ElectronicsClubAltona/Swag-Badge/Rockling-LayoutTest/Images/Rockling 02.jpg

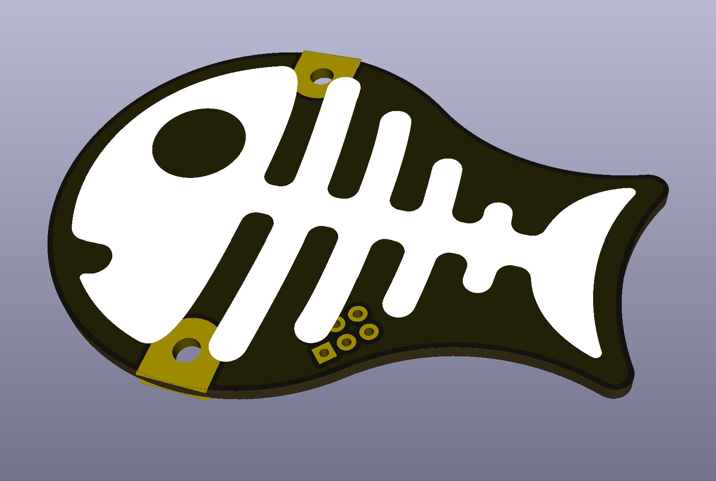
Rockling-LayoutTest/Images/Rockling 02.jpg
