ElectronicsClubAltona/Swag-Badge/Tiling The Plane.jpg

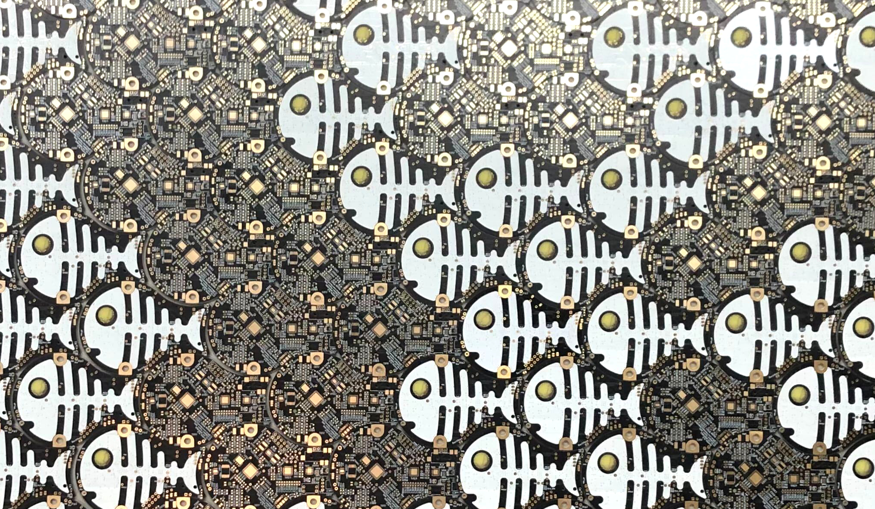
Tiling The Plane.jpg
