ElectronicsClubAltona/Swag-Badge/Swag-Badge-2022/README.md

# Linux Conf AU 2021 Swag Badge

Hardware design files for the [LCA 2022](http://lca2022.linux.org.au/) attendee swag badge.

See the [Swag Badge](http://www.openhardwareconf.org/wiki/Swagbadge2021) wiki for project details.

A project by Melbourne [Connected Community HackerSpace](https://www.hackmelbourne.org/)

Licensed under MIT (See the [license](LICENSE) file)
