ElectronicsClubAltona/Swag-Badge/Swag-Badge-2022/Resource/320 x 240 SPI Screen Spec.rtf

MRD_TFT240_8P_CS
Banggood
https://www.banggood.com/2_4-Inch-240320-Color-HD-LCD-TFT-Screen-SPI-Serial-Display-Module-ILI9341-p-1384915.html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
AliExpress
https://www.aliexpress.com/item/1005001543742305.html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 (https://www.aliexpress.com/item/1005001543742305.html)

Feature:

Size: 2.4 inches
Drive chip: ILI9341
Touch type: without touching
Resolution: 240*320
Communication interface: SPI

Interface description:

1. GND (power ground)
2. VCC (power supply is 3.3V)
3. CLK (clock line)
4. MOSI (data input)
5. RES (reset line)
6. DC (data / command selection line)
7. BLK (backlight)
8. MISO (data output)

Pin description:

If you want to save IO port, BLK backlight can not be connected. The system has been designed to illuminate the backlight even if it is not connected. If you need to turn off the backlight, you need to connect BLK to low level or directly to ground.
MISO is the output signal of the screen. If you do not need to read the information of the screen, this pin can be disconnected. A minimum of 4 IO ports are required to operate.
