ElectronicsClubAltona/Swag-Badge/Tiling The Plane 02.jpg

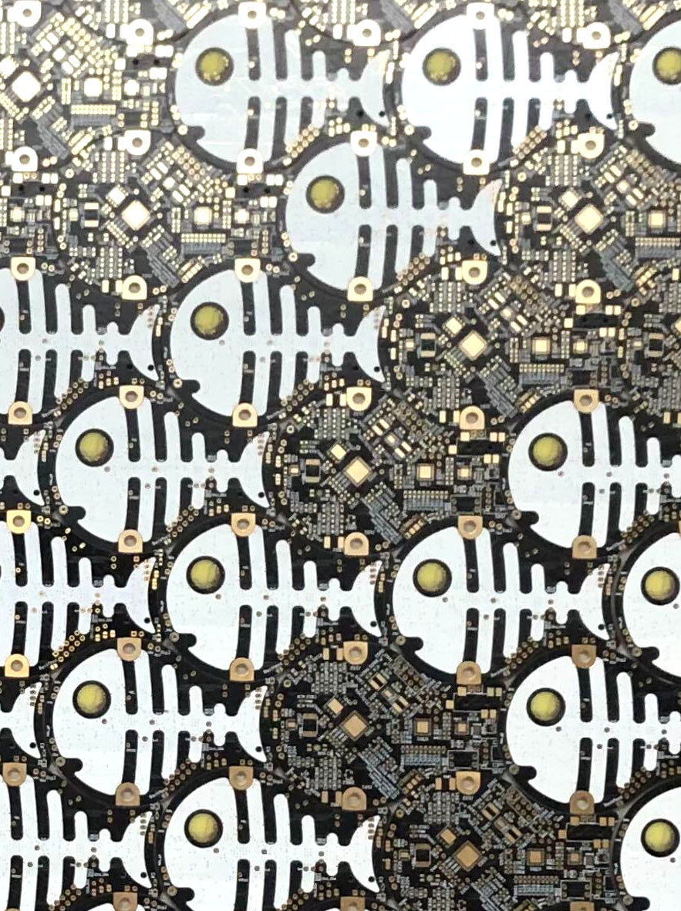
Tiling The Plane 02.jpg
