ElectronicsClubAltona/Swag-Badge/Tux Eyes/Tux Eyes - No Pupils 01.png

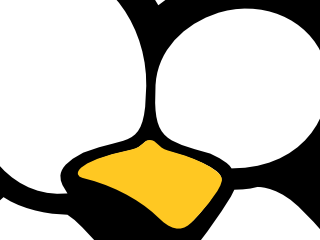
Tux Eyes/Tux Eyes - No Pupils 01.png
