ElectronicsClubAltona/Swag-Badge/Tux Eyes/Tux Eyes.jpg

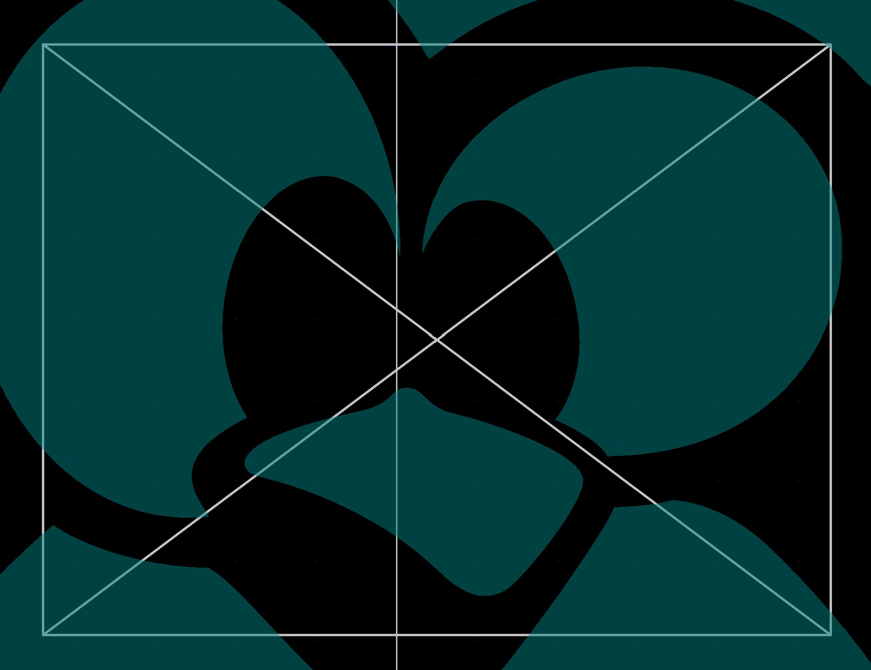
Tux Eyes/Tux Eyes.jpg
