ElectronicsClubAltona/Swag-Badge/Tux Eyes/Tux Eyes.png

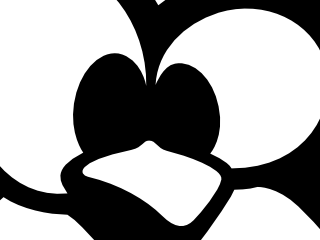
Tux Eyes/Tux Eyes.png
