ElectronicsClubAltona/Swag-Badge/Tux Eyes/Tux Eyes - Components.png

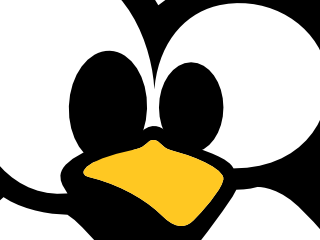
Tux Eyes/Tux Eyes - Components.png
