ElectronicsClubAltona/Swag-Badge/Rockling-LayoutTest/DXF/Rockling EdgeCuts 57mm.dxf

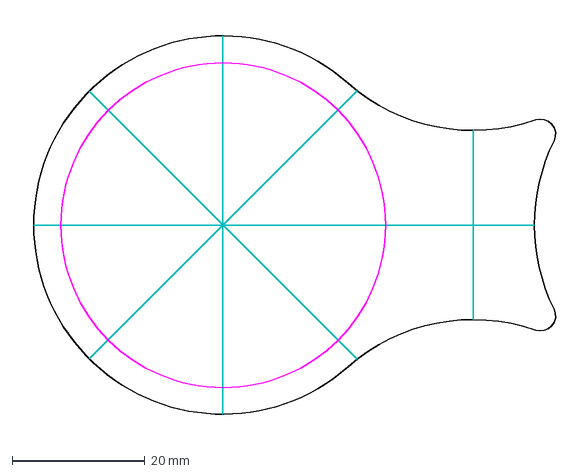
[picture p8: CAD file, 2021-08-23]
Rockling-LayoutTest/DXF/Rockling EdgeCuts 57mm.dxf
81.4 x 63.0 mm
