ElectronicsClubAltona/Swag-Badge/Swag-Badge-2022/DXF/Tux EdgeCuts Circ 02.dxf

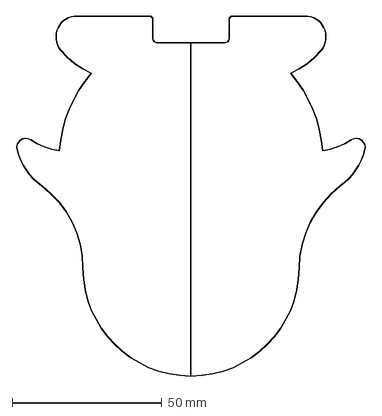
[picture p9: CAD file, 2021-08-26]
Swag-Badge-2022/DXF/Tux EdgeCuts Circ 02.dxf
116.6 x 120.0 mm
