ElectronicsClubAltona/Swag-Badge/Rockling-LayoutTest/DXF/Rockling EdgeCuts 54mm.dxf

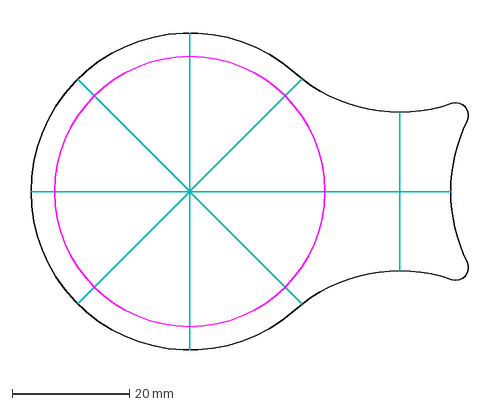
[picture p10: CAD file, 2021-08-23]
Rockling-LayoutTest/DXF/Rockling EdgeCuts 54mm.dxf
77.1 x 59.6 mm
