ElectronicsClubAltona/Swag-Badge/Swag-Badge-2022/3D Models/SPI Screen.step

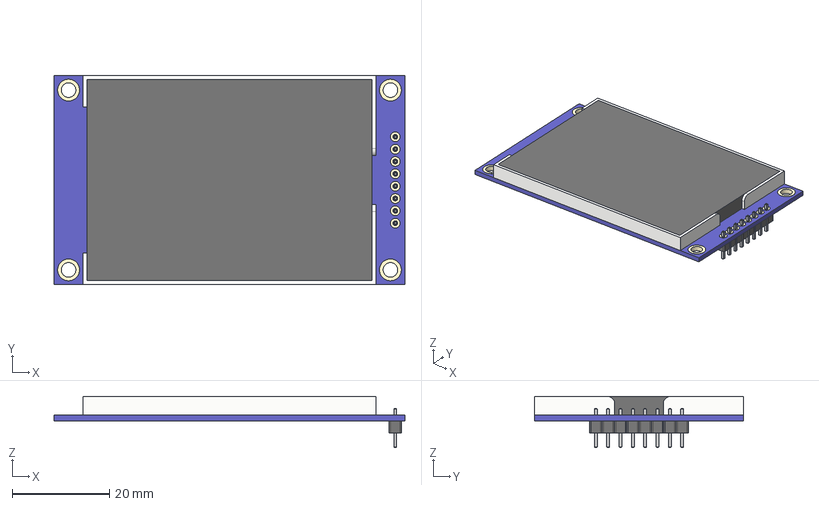
[picture p11: CAD file, 2021-08-23]
Swag-Badge-2022/3D Models/SPI Screen.step
72.3 x 43.0 x 10.5 mm
FR4
Through-Hole
Pins
Screen Module
