ElectronicsClubAltona/Swag-Badge/Swag-Badge-2022/DXF/Tux EdgeCuts Circ 03.dxf

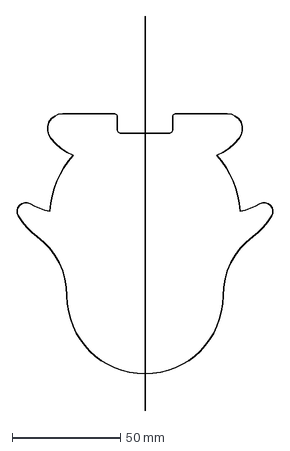
[picture p12: CAD file, 2021-08-26]
Swag-Badge-2022/DXF/Tux EdgeCuts Circ 03.dxf
118.8 x 182.0 mm
