ElectronicsClubAltona/Swag-Badge/Rockling-LayoutTest/DXF/Rockling EdgeCuts 55mm.dxf

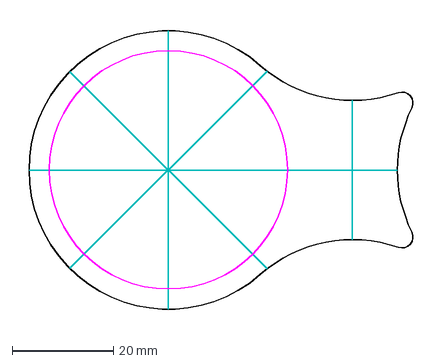
[picture p13: CAD file, 2021-08-23]
Rockling-LayoutTest/DXF/Rockling EdgeCuts 55mm.dxf
78.6 x 60.8 mm
