ElectronicsClubAltona/Swag-Badge/Swag-Badge-2022/3D Models/LOLIN32 Lite.step

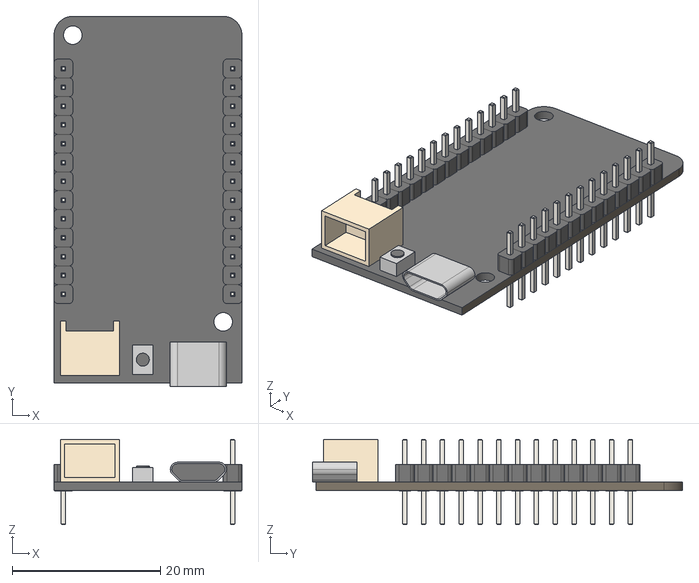
[picture p14: CAD file, 2021-08-13]
Swag-Badge-2022/3D Models/LOLIN32 Lite.step
25.4 x 50.0 x 11.6 mm
