ElectronicsClubAltona/Swag-Badge/Swag-Badge-2022/DXF/Tux EdgeCuts Circ 01.dxf

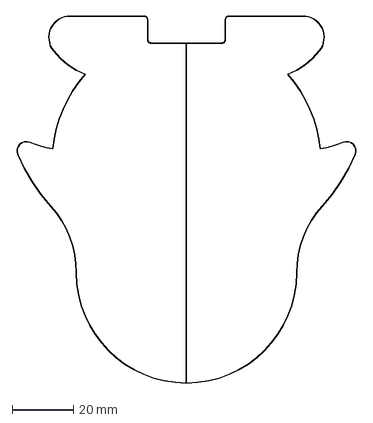
[picture p15: CAD file, 2021-08-26]
Swag-Badge-2022/DXF/Tux EdgeCuts Circ 01.dxf
111.3 x 120.0 mm
