ElectronicsClubAltona/Swag-Badge/Rockling-LayoutTest/DXF/Rockling EdgeCuts 50mm.dxf

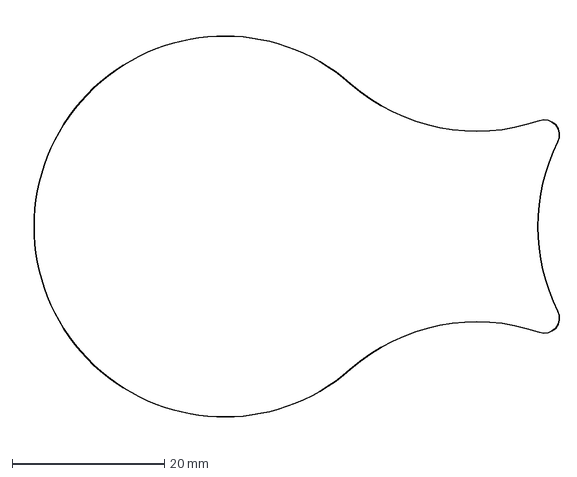
[picture p16: CAD file, 2021-08-14]
Rockling-LayoutTest/DXF/Rockling EdgeCuts 50mm.dxf
71.4 x 55.2 mm
