ElectronicsClubAltona/Swag-Badge/Swag-Badge-2022/3D Models/0.96 OLED v3.step

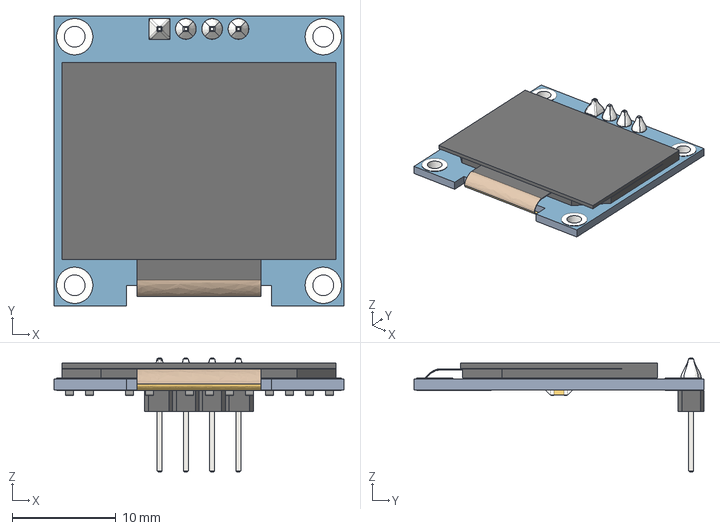
[picture p17: CAD file, 2021-08-13]
Swag-Badge-2022/3D Models/0.96 OLED v3.step
28.0 x 28.0 x 11.0 mm
