ElectronicsClubAltona/Swag-Badge/Swag-Badge-2022/DXF/Tux EdgeCuts 02.dxf

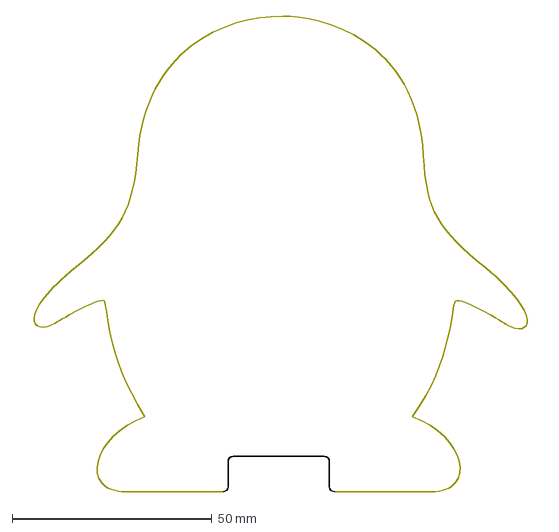
[picture p18: CAD file, 2021-08-26]
Swag-Badge-2022/DXF/Tux EdgeCuts 02.dxf
132.0 x 119.2 mm
