ElectronicsClubAltona/Swag-Badge/Rockling-LayoutTest/DXF/AntennaMountInset.dxf

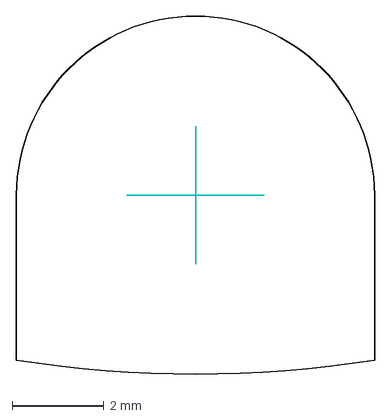
[picture p19: CAD file, 2021-08-14]
Rockling-LayoutTest/DXF/AntennaMountInset.dxf
7.80 x 7.90 mm
