ElectronicsClubAltona/Swag-Badge/Swag-Badge-2022/3D Models/Tactile_SMD_3x6x2.5mm.STEP

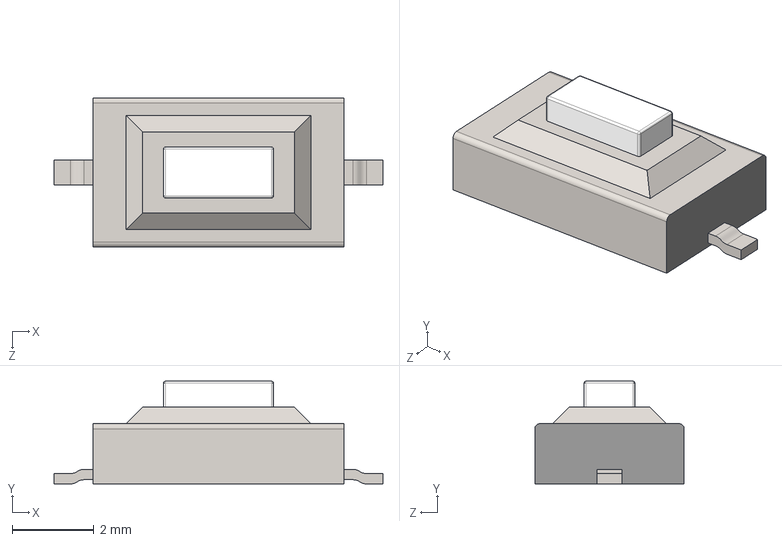
[picture p20: CAD file, 2021-08-13]
Swag-Badge-2022/3D Models/Tactile_SMD_3x6x2.5mm.STEP
8.05 x 2.51 x 3.66 mm
