ElectronicsClubAltona/Swag-Badge/Swag-Badge-2022/DXF/SPI Screen Footprint.dxf

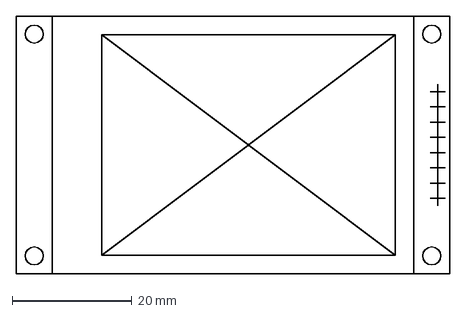
[picture p21: CAD file, 2021-08-23]
Swag-Badge-2022/DXF/SPI Screen Footprint.dxf
72.3 x 43.0 mm
