ElectronicsClubAltona/Swag-Badge/Rockling-LayoutTest/DXF/ReferenceLines 50mm.dxf

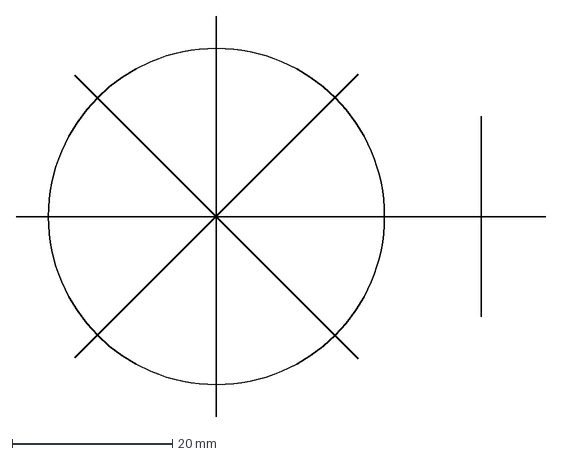
[picture p22: CAD file, 2021-08-14]
Rockling-LayoutTest/DXF/ReferenceLines 50mm.dxf
66.1 x 50.0 mm
