ElectronicsClubAltona/Swag-Badge/Swag-Badge-2022/3D Models/6x3mm Button.stp

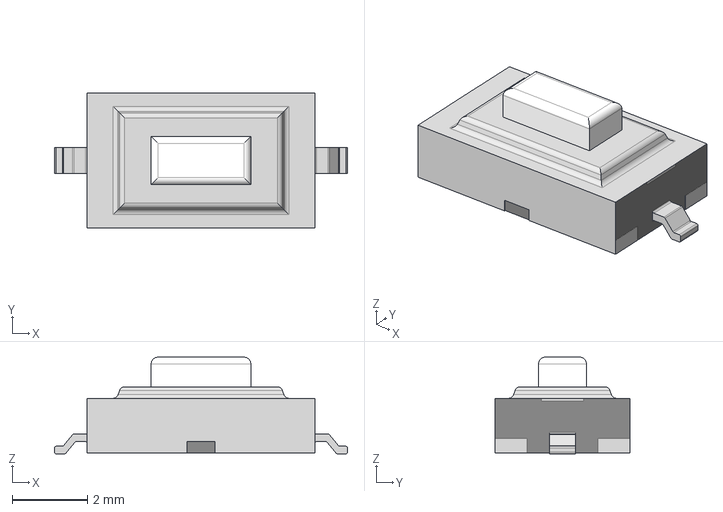
[picture p23: CAD file, 2021-08-13]
Swag-Badge-2022/3D Models/6x3mm Button.stp
7.77 x 3.58 x 2.57 mm
