ElectronicsClubAltona/Swag-Badge/Swag-Badge-2022/DXF/Tux EdgeCuts 01.dxf

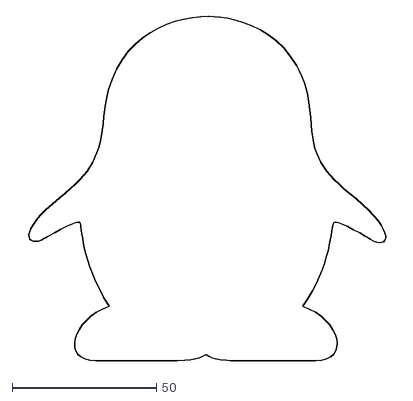
[picture p24: CAD file, 2021-08-13]
Swag-Badge-2022/DXF/Tux EdgeCuts 01.dxf
132.0 x 119.2
