ElectronicsClubAltona/Swag-Badge/Rockling-LayoutTest/DXF/AntennaMount.dxf

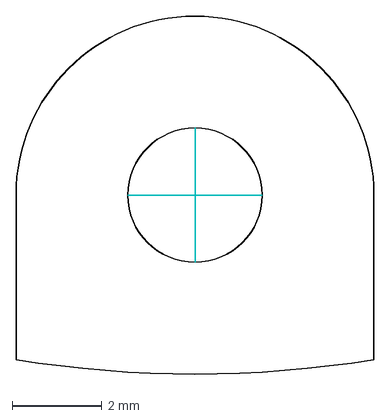
[picture p25: CAD file, 2021-08-14]
Rockling-LayoutTest/DXF/AntennaMount.dxf
8.00 x 8.11 mm
