ElectronicsClubAltona/Swag-Badge/Swag-Badge-2022/DXF/Slider Silk.dxf

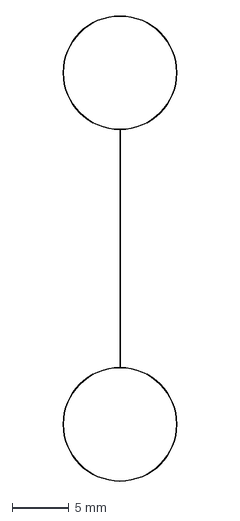
[picture p26: CAD file, 2021-08-13]
Swag-Badge-2022/DXF/Slider Silk.dxf
10.0 x 41.0 mm
