ElectronicsClubAltona/Swag-Badge/Swag-Badge-2022/DXF/Master Layout Grid.dxf

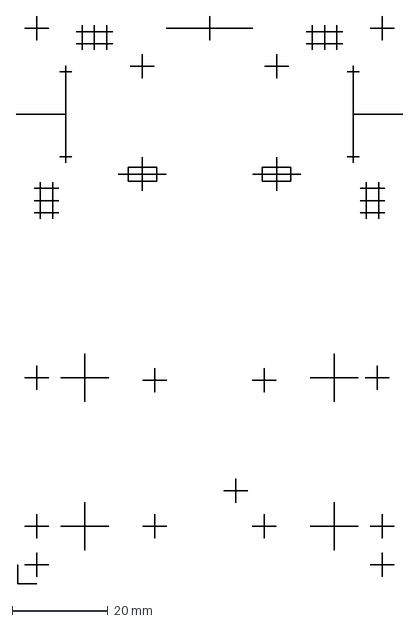
[picture p27: CAD file, 2021-08-13]
Swag-Badge-2022/DXF/Master Layout Grid.dxf
80.6 x 118.5 mm
