ElectronicsClubAltona/Swag-Badge/Swag-Badge-2022/DXF/EdgeCuts01.dxf

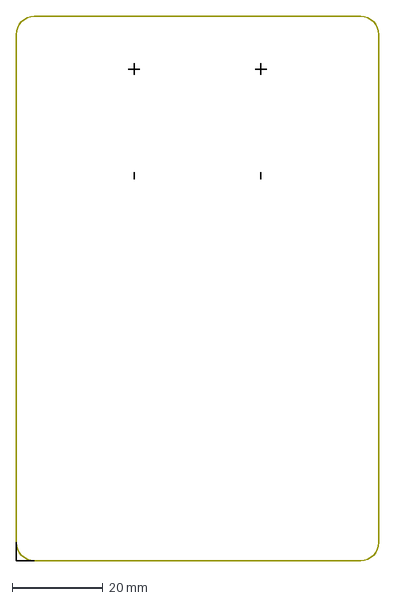
[picture p28: CAD file, 2021-08-13]
Swag-Badge-2022/DXF/EdgeCuts01.dxf
80.0 x 120.0 mm
