ElectronicsClubAltona/Swag-Badge/Swag-Badge-2022/DXF/Slider 4Finger Pads.dxf

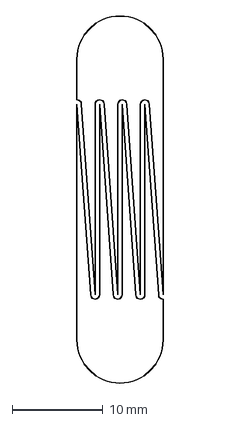
[picture p29: CAD file, 2021-08-13]
Swag-Badge-2022/DXF/Slider 4Finger Pads.dxf
9.50 x 40.5 mm
