ElectronicsClubAltona/Swag-Badge/(list of files, cad)

Other CAD files:
Swag-Badge-2022/3D Models/1825910-6.step
