ElectronicsClubAltona/Swag-Badge/Rockling-LayoutTest/Images/Rockling 01.jpg

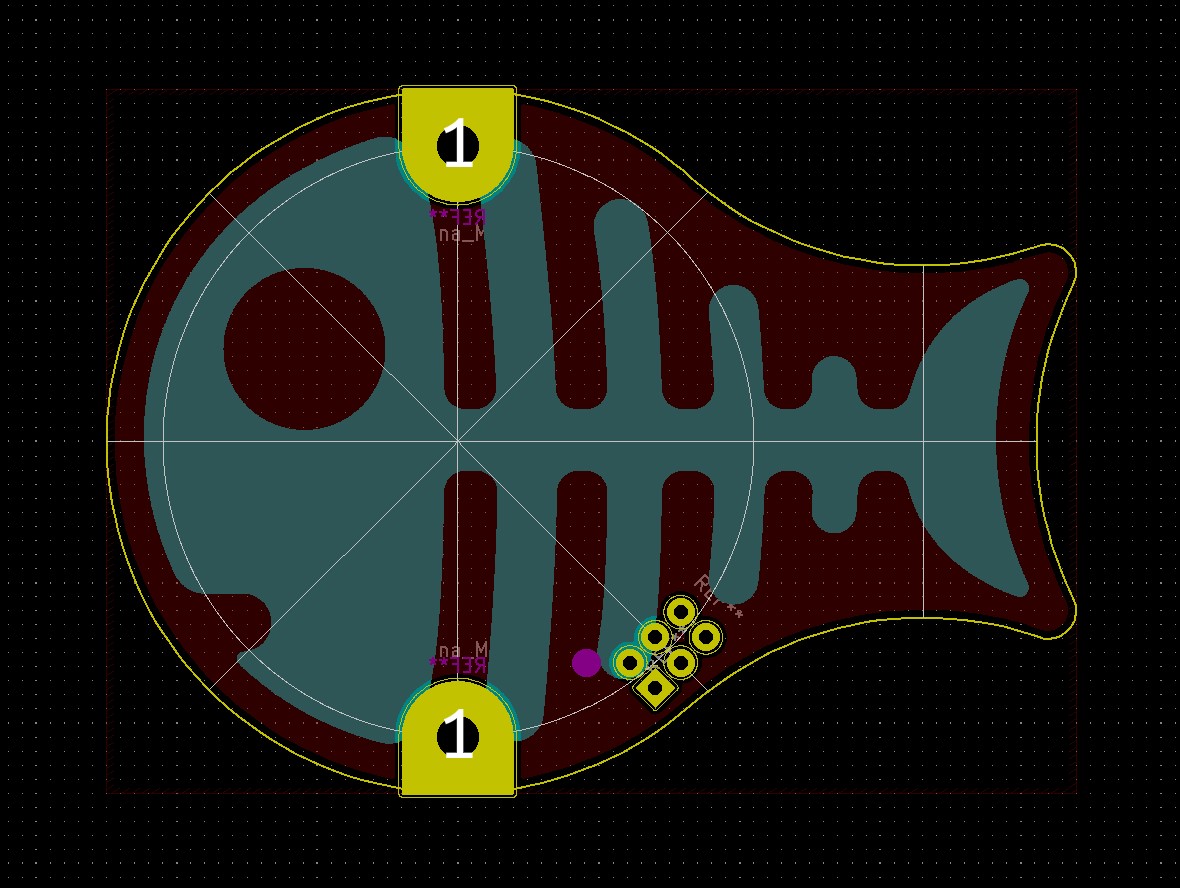
Rockling-LayoutTest/Images/Rockling 01.jpg
