ElectronicsClubAltona/Swag-Badge/(commit log)

2021-08-13 Reorganized
    Changed repo structure for 2022
    [0.96 OLED v3.step, 6x3mm Button.stp, EdgeCuts01.dxf, LOLIN32 Lite.step, Master Layout Grid.dxf, Slider 4Finger Pads.dxf, Slider Silk.dxf, Tactile_SMD_3x6x2.5mm.STEP]
2021-08-14 Rockling LayoutTest Added
    [AntennaMount.dxf, AntennaMountInset.dxf, EdgeCuts.dxf, ReferenceLines.dxf, Rockling-LayoutTest.kicad_pcb, Rockling-LayoutTest.sch]
2021-08-22 Resources added
    [Rockling-LayoutTest-B_Cu.gbr, Rockling-LayoutTest-B_Mask.gbr, Rockling-LayoutTest-B_SilkS.gbr, Rockling-LayoutTest-Edge_Cuts.gbr, Rockling-LayoutTest-F_Cu.gbr, Rockling-LayoutTest-F_Mask.gbr, Rockling-LayoutTest-F_SilkS.gbr, Rockling-LayoutTest-NPTH.drl]
2021-08-23 3D SPI Screen model added
    [SPI Screen Footprint.dxf, SPI Screen.step, swag-badge - Backup.kicad_pcb, swag-badge.kicad_pcb, swag-badge.sch]
2021-08-23 Update SPI Screen.step
    [SPI Screen.step]
2021-08-23 Larger EdgeCuts and Silks added
    [ReferenceLines 50mm.dxf, Rockling EdgeCuts 50mm.dxf, Rockling EdgeCuts 54mm.dxf, Rockling EdgeCuts 55mm.dxf, Rockling EdgeCuts 57mm.dxf]
2021-08-24 Edgecuts and Silks combined as footprints
2021-08-26 EdgeCuts and Footprints updated
    [Tux EdgeCuts 01.dxf, Tux EdgeCuts 02.dxf, Tux EdgeCuts Circ 01.dxf, Tux EdgeCuts Circ 02.dxf, Tux EdgeCuts Circ 03.dxf, swag-badge.kicad_pcb, swag-badge.sch]
2021-08-27 Label Change
    [swag-badge.sch]
2021-08-27 SAO + SPI changes. Needs further attention.
    [swag-badge.kicad_pcb, swag-badge.sch]
2021-08-27 Removing unused touch pads.
    [swag-badge.kicad_pcb, swag-badge.sch]
2021-08-27 Swap slider pins. Notes on schematic.
    [swag-badge.sch]
2021-08-28 Silks updated
    [swag-badge.kicad_pcb]
2021-08-28 Swapped Slider Footprint
    [swag-badge.kicad_pcb, swag-badge.sch]
2021-08-29 Slider pad clearance increased
    [swag-badge.kicad_pcb, swag-badge.sch]
2021-08-30 QR Code added
    [swag-badge.kicad_pcb]
2021-09-04 Changing the SAO pinout to be alternating pin numbers.
    [swag-badge.kicad_pcb, swag-badge.sch]
2021-09-04 I have altered the SAO pinmap. Pray I do not alter it again.
    [swag-badge.kicad_pcb, swag-badge.sch]
2021-09-04 Adding notes.
    [swag-badge.sch]
2021-09-08 Adding a reset button.
    [1825910-6.step, swag-badge.kicad_pcb, swag-badge.sch]
2021-09-08 LOLIN flipped - Silk labels updated
    [swag-badge - Backup 2021-08-13.kicad_pcb, swag-badge - Backup 2021-09-09.kicad_pcb, swag-badge.kicad_pcb]
2021-09-09 Schematic edited - Screen
    [swag-badge - Backup 2021-09-09.kicad_pcb, swag-badge.kicad_pcb, swag-badge.sch]
2021-09-09 Minor schematic edit
    [swag-badge.kicad_pcb, swag-badge.sch]
2021-09-09 SAO_2 edit
    [swag-badge.sch]
2021-09-09 SAO_2 Swapped to 6-pin
    [swag-badge.kicad_pcb, swag-badge.sch]
2021-09-09 10 Pin SAO_2 removed from schematic
    [swag-badge.sch]
2021-09-09 Maybe ready for trace work
    [swag-badge.kicad_pcb, swag-badge.sch]
2021-09-10 Schematic fixes in, nearly routed.
    [swag-badge.kicad_pcb, swag-badge.sch]
2021-09-10 DRC. Checks needed.
    [swag-badge.kicad_pcb]
2021-09-10 First pass at Gerbers for Swag-Badge.
    [swag-badge-B_Cu.gbl, swag-badge-B_Cu.gbr, swag-badge-B_Mask.gbr, swag-badge-B_Mask.gbs, swag-badge-B_Paste.gbp, swag-badge-B_SilkS.gbo, swag-badge-B_SilkS.gbr, swag-badge-Edge_Cuts.gbr]
2021-09-11 Updated back appearance. New Gerbers in .zip.
    [swag-badge-B_Cu.gbl, swag-badge-B_Mask.gbs, swag-badge-B_Paste.gbp, swag-badge-B_SilkS.gbo, swag-badge-Edge_Cuts.gm1, swag-badge-F_Cu.gtl, swag-badge-F_Mask.gts, swag-badge-F_Paste.gtp]
2021-09-11 Clean up save state of .sch, .kicad_pcb. Should be no change.
    [swag-badge.kicad_pcb, swag-badge.sch]
2021-09-13 Neatened Back Silk
    [swag-badge.kicad_pcb]
2021-09-13 Linux Australia text added
    [swag-badge.kicad_pcb]
2021-09-24 Header labels added
    [swag-badge.kicad_pcb]
2021-09-24 Labels updated
    [swag-badge.kicad_pcb]
2021-11-01 Screen and SAO pinout changes
    [swag-badge.kicad_pcb, swag-badge.sch]
2021-11-02 Schematic updated
    [swag-badge.sch]
2021-11-02 SAO headers reassigned
    [swag-badge.sch]
2021-11-03 Trace work partially updated
    [swag-badge - Backup 2021-11-03.kicad_pcb, swag-badge.kicad_pcb, swag-badge.sch]
2021-11-04 Gerbers updated
    [swag-badge-B_Cu.gbl, swag-badge-B_Cu.gbr, swag-badge-B_Mask.gbr, swag-badge-B_Mask.gbs, swag-badge-B_Paste.gbp, swag-badge-B_SilkS.gbo, swag-badge-B_SilkS.gbr, swag-badge-Edge_Cuts.gbr]
2021-11-06 Cleaning things up
    [swag-badge.kicad_pcb]
2021-11-08 Neatening up schematic (no actual changes made).
    [swag-badge.sch]
2021-11-09 Clearance adjusted on BCK trace
    [swag-badge.kicad_pcb]
2021-11-09 Touch traces modified
    [swag-badge.kicad_pcb]
2021-11-22 v1-0 Gerbers deleted
    [swag-badge.kicad_pcb]
